Jyotishman-Deori/async-fifo/docs/board_photo.jpg

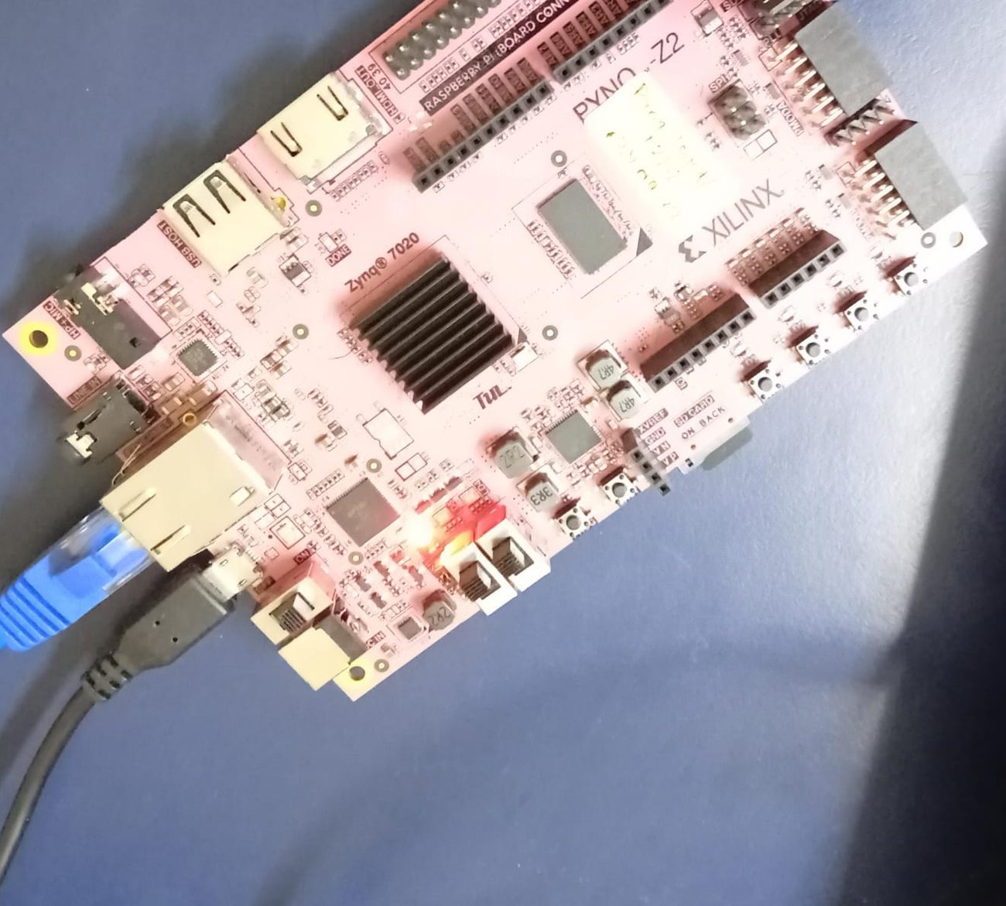
docs/board_photo.jpg
