Jyotishman-Deori/async-fifo/(commit log)

2026-08-15 RTL, testbench, assertions and synthesis check
    async_fifo.sv and sync_2ff.sv, with the two-flop synchroniser kept as its
    own module so it is obvious it wasn't skipped.
    Testbench runs both clock ratios in one go and drains the FIFO at the end
    of each phase, so every word written is compared on the way out. Checks
    occupancy against the DUT's own pointers rather than counting writes and
    reads in the testbench, which goes wrong by one whenever the two clock
    edges happen to coincide.
    SVA and covergroups are bound onto the DUT in a separate file. ModelSim
    ASE supports neither, so that half runs under XSim.
    Synthesis check now defines both clocks before report_cdc. Without them
    the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
    [async_fifo.sv, async_fifo_exp.sv, sync_2ff.sv]
2026-08-16 Move the RTL to Verilog-2001
    The design is the part that claims to be Verilog, so it should actually be
    Verilog rather than SystemVerilog that happens to avoid the fancy bits.
    logic to reg/wire, always_ff to always, sized replications instead of '0,
    plain parameters instead of parameter int.
    Testbench and the bound checker stay SystemVerilog. A scoreboard and
    covergroups in Verilog-2001 would be an exercise in stubbornness, and
    keeping the split exactly at the RTL boundary means the synthesisable half
    is portable to tools that only take Verilog.
    Build scripts updated: vlog and xvlog now compile the RTL without -sv, and
    read_verilog drops -sv. Everything re-run against the Verilo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
    [async_fifo.v, async_fifo_exp.v, sync_2ff.v]
2026-08-16 Cut the noise out of the repo
    synth_check.tcl was dumping all nine report_utilization sections, seven of
    which are solid zeros for a design this size. It now echoes Slice Logic and
    Memory only, which took results/synth_check.txt from 246 lines to 85. The
    CDC and utilization files the tool has to write are gitignored, since the
    parts worth keeping are already echoed into results/.
    Fixed two things that were showing up in the committed evidence rather than
    hiding them. ModelSim was logging "Error 133: unable to remove directory"
    because a bare vdel -all goes after whatever the current library happens to
    be; it is vdel -lib work -all now. XSim was warning once per instance that
    the R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
2026-08-16 Run the FIFO on a PYNQ-Z2
    286,176,459 words through the real thing with zero errors, both full and
    empty reached. The simulation checked 10,017.
    The clocks are the entire reason for doing this, so wclk is FCLK_CLK0 off
    the PS PLL and rclk is the board's 125 MHz oscillator. Two crystals, no
    common reference, so the phase drifts and the sampling point sweeps the
    whole space over a run. Deriving the second clock from an MMCM would have
    been half the work and would have proved less than the simulation did,
    because phase locked clocks sample at the same few relative phases forever
    and might never catch the synchroniser in its window. The PS is in this
    design for that and nothing else.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
    [fifo_hw_test.v, pynq_z2.xdc, top_pynq_z2.v]
2026-08-16 Add the project report as a PDF
    Eleven pages covering the design, the verification, the skew experiment,
    synthesis and the hardware run, with a block diagram and every figure
    traced back to a transcript in results/.
    Built from docs/report.html by docs/make_pdf.py. Chrome does the layout
    because it handles print CSS properly; page numbers are stamped afterwards
    with PyMuPDF, since Chrome does not implement CSS @page margin boxes and
    there is no other way to get them. Verified by rendering every page back to
    an image and checking that no text block crosses a margin.
    Body is Cambria, headings Segoe UI, code Consolas. Tables are fixed layout
    and code blocks wrap, so nothing can overflow the co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
2026-08-16 Restructure the report to the seminar report format
    Front matter, numbered sections, running heads and IEEE references, laid
    out the same way as my MTech seminar report: cover, abstract, contents,
    list of figures and tables, then Introduction through Future Work.
    Contents page numbers are real. Chrome has no target-counter(), so
    make_pdf.py renders once, locates each heading in that output, substitutes
    the numbers and renders again. Pagination is stable across the two passes
    because every number sits in a fixed-width right-aligned slot and cannot
    reflow a line. The search is floored at the first body page, otherwise the
    Contents and the figure lists match their own entries.
    Running heads,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
2026-08-16 Put the IIT Bombay crest on the report cover
    Sits between the department line and the title rule, 33 mm wide, matching
    the seminar report layout. Downscaled from 1200 px to 560 px, which is
    still about 430 dpi at that size and keeps the PDF under 700 KB.
    Cover height had room for it without reflowing; still 21 pages and no
    blank page after the cover.
2026-08-16 Tidy the README before publishing
    The report was the one thing a visitor could not find: it is now linked from
    the top and docs/ is listed in the layout, which it was not.
    Running it stopped at the experiment and never mentioned the hardware flow
    or how to rebuild the report, so both are in the list now.
    Thousands separators were spaces in this file and commas everywhere else.
    All commas.
2026-08-16 Drop the self-quiz from the end of the README
    "Questions I should be able to answer" was a study note that ended up in
    public documentation. Two of the eight are things the repo deliberately does
    not answer, MTBF and non-power-of-two depth, so listing them raised a gap
    without framing it.
    The limitations are already stated properly in hw/README.md and in the
    report, where they read as a scoped boundary rather than a to-do list, and
    the depth is carried by the results themselves.
    README now ends on the hardware numbers. Questions kept locally in
    interview-prep.md, which is gitignored.
2026-08-16 Cut the report back to a standard project report
    It had grown into something closer to a paper: literature review, a
    hypothesis-testing experiment with its own analysis, a limitations section,
    future work, lists of figures and tables. Twenty-one pages for a self project.
    Now ten pages, structured as design, verification, results, conclusion. Kept
    the cover, the block diagram, the pointer and flag derivation, the assertion
    list, and the three result tables. Fault injection stays because it is three
    sentences and it is what gives the passing results weight.
    Dropped the skew experiment from the report. It is still in experiments/ for
    anyone who wants it, but it needed two pages and a careful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
2026-08-16 Add the hardware setup diagram and the run output to the report
    Figure 2 is the block diagram of what was implemented in the PYNQ-Z2 fabric:
    the two independent clock sources, the LFSR stimulus and reference, the FIFO
    between them, the counters and the VIO readout.
    Figure 3 is the console output of the hardware run, pasted verbatim from
    results/hardware_test.txt rather than retyped, so the numbers in the figure
    and in Table 5 come from the same place.
    No GUI screenshots. The whole flow ran headless from batch tcl and xsdb, so
    there was nothing on screen to capture, and write_bd_layout produces nothing
    without the GUI canvas. The block design itself is one Zynq PS block with
    FCLK_CLK0 broug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
2026-08-16 Add a photo of the board running the test
    Figure 4. Taken with the design loaded and the test live: the indicator beside
    the DONE marking shows the fabric is configured, and a user LED is being driven
    by the test logic.
    Rotated to read the right way up and cropped to the board. The only link the
    flow uses is USB JTAG, and there is no SD card in the slot, which the caption
    says because it is the part people assume must be there.
2026-08-17 Keep the conclusion on one page
    It was splitting under the board photo, with the heading and first paragraph
    on one page and the rest on the next. Forced onto its own page, so the
    conclusion and the references now read as a single closing page.
2026-08-17 Convert the whole project to Verilog-2001
    Everything is now plain Verilog: design, testbench, experiment and hardware
    harness. Nothing anywhere compiles with -sv.
    tb_async_fifo.sv became tb_async_fifo.v. logic to reg/wire, int to integer,
    task automatic to task, and $urandom_range to {$random(seed)} % 100, with a
    separate seed per clock domain so the two stimulus streams cannot disturb one
    another. The concatenation around $random is what forces the result unsigned
    before the modulo; without it the negative half of the range folds the wrong
    way and the rates come out skewed.
    tb_cdc_experiment.sv became .v the same way, plus explicit port connections
    in place of .*, which is SystemVerilog o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
    [tb_async_fifo.v, tb_cdc_experiment.v]
